jaysonragasa/esp32_robot_dog_new/images/20260614_181552.jpg

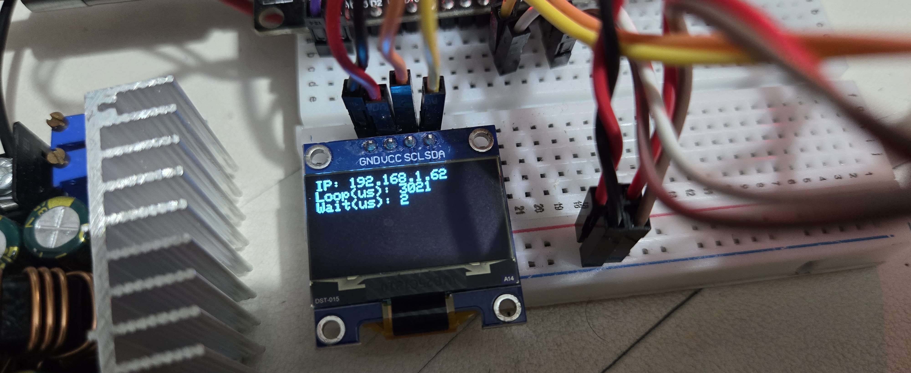
images/20260614_181552.jpg
