jaysonragasa/esp32_robot_dog_new/src/powerSensor.ino

bool powerSensorReady = false;
void initPowerSensor() {
  Serial.print("Power sensor ");
  #if POWER_SENSOR == INA219
    Serial.print("INA219");
  #else
    Serial.print("<NO>");
  #endif
  setupPowerSensor();
  Serial.println();
}

void updatePower() {
  #if POWER_SENSOR == INA219
  voltage_V = powerSensorReady ? ina219.getBusVoltage_V() : 0.0;
  current_A = powerSensorReady ? ina219.getCurrent_mA() / 1000 : 0.0;
  #endif
}

void setupPowerSensor()
{
  #if POWER_SENSOR == INA219
    ina219 = INA219_WE();

    if (ina219.init()) {
      powerSensorReady = true;
      ina219.setADCMode(INA219_BIT_MODE_9);  // just to make it fast
      ina219.setPGain(INA219_PG_320);
      ina219.setBusRange(INA219_BRNG_16);
    } else {
      Serial.println("Failed to find INA219 chip");
    }
  #endif
}

// return V
double getPowerSensorVoltage() {
  #if POWER_SENSOR == INA219
  return voltage_V;
  #else
  return 0.0;
  #endif
}


// return A
double getPowerSensorCurrent() {
  #if POWER_SENSOR == INA219
  return current_A;
  #else
  return 0.0;
  #endif
}
