jaysonragasa/esp32_robot_dog_new/src/index.html.gz.h

#define index_html_gz_len 2614
static const uint8_t index_html_gz[] PROGMEM = {31,139,8,0,0,0,0,0,0,10,173,26,107,115,219,54,242,179,60,227,255,176,213,141,143,84,44,81,84,18,183,30,89,244,93,31,105,154,94,122,211,169,211,246,58,153,76,7,34,33,9,49,8,240,0,80,18,147,248,191,223,0,32,64,82,15,199,185,84,51,14,201,125,239,98,119,177,32,51,91,169,156,94,159,158,204,86,24,101,250,170,136,162,248,250,23,62,231,234,59,190,252,109,50,27,91,200,233,201,76,170,202,220,244,230,60,171,222,159,158,244,122,163,13,158,223,18,53,82,188,76,87,163,20,81,202,75,53,5,198,25,190,106,227,75,137,197,72,98,138,211,14,246,86,43,63,134,204,249,187,163,40,121,4,115,24,202,215,88,200,84,112,74,71,115,188,66,107,194,69,11,91,160,44,35,108,57,133,216,60,230,72,44,9,115,79,43,76,150,43,53,133,73,28,159,25,192,134,100,106,213,60,223,157,158,244,162,148,51,133,8,195,2,222,31,228,201,136,44,40,170,166,176,160,120,107,32,250,102,148,17,129,83,69,56,155,66,202,105,153,51,39,240,111,82,33,85,74,43,109,193,153,26,45,80,78,104,53,133,156,51,46,11,148,98,79,170,117,11,78,107,90,138,183,83,152,56,228,63,115,156,17,4,50,21,24,51,64,44,131,144,11,130,153,66,70,107,193,133,18,136,168,129,101,142,222,242,74,42,146,222,254,185,20,188,44,44,240,128,237,251,254,221,227,142,177,67,255,125,220,28,138,88,38,83,84,224,207,182,199,233,108,36,236,172,144,137,211,69,77,189,203,222,225,180,244,59,139,190,175,113,142,210,91,109,37,203,70,36,71,75,60,133,82,208,176,159,33,133,166,6,48,150,235,229,249,54,167,195,179,39,223,202,245,18,182,57,101,50,9,86,74,21,211,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
64,36,40,156,23,92,32,81,129,226,128,145,172,96,141,40,209,111,87,224,197,191,44,235,216,37,205,129,215,219,145,249,98,132,51,151,70,135,207,218,235,200,102,223,145,227,118,237,135,205,206,122,168,110,18,188,251,74,160,161,238,190,14,240,74,252,4,106,19,164,137,174,182,222,63,212,3,173,127,222,200,230,254,164,253,77,103,236,190,199,141,235,255,255,240,63,229,22,49,155,8,33,0,0};
