jaysonragasa/esp32_robot_dog_new/(commit log)

2026-06-13 Fixes for web build pipeline, I2C lockup, and servo mapping
    [HAL.ino, HAL_ESP32PWM.ino, HAL_PCA9685.ino, WiFi.ino, cliSet.ino, config.h]
2026-06-13 Update README with Background and BOM
2026-06-13 Explain hardware safety overhaul and high current limits
2026-06-13 Update telemetry LCD and fix Serial loop warnings
    [cliSet.ino, robot_dog_esp32.ino]
2026-06-13 Fix servo frequency and I2C bottleneck for torque
    [HAL_PCA9685.ino, config.h]
2026-06-14 feat: initialize ESP32 robot dog project with multi-core architecture and I2C-managed peripheral control
2026-06-14 chore: add hardware reference image for ESP32 project configuration
2026-06-14 feat: optimize I2C performance, improve kinematics, and add Web UI gait presets
2026-06-15 feat: implement HAL framework with PCA9685 support, servo control, and web interface base
2026-06-15 Fix web UI bugs: restore joysticks, sliders throttling, and calibration degree values
    [index.html.gz.h]
